DominikWawak/Project2/images/background.jpg

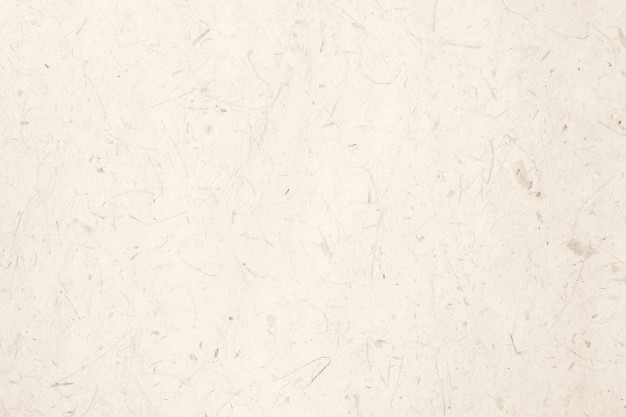
images/background.jpg
