DominikWawak/Project2/images/drawerbg.jpg

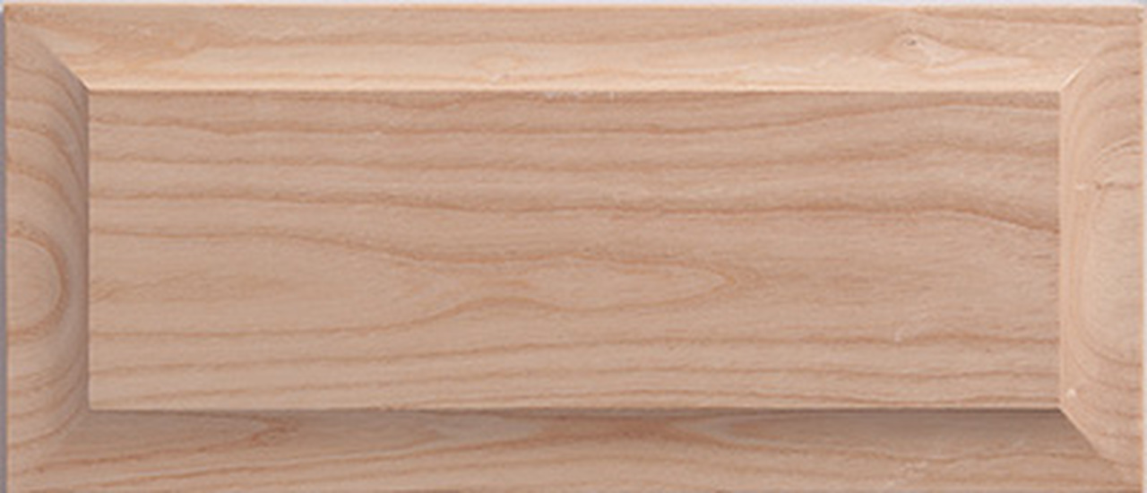
images/drawerbg.jpg
