DominikWawak/Project2/images/drawerfront.jpg

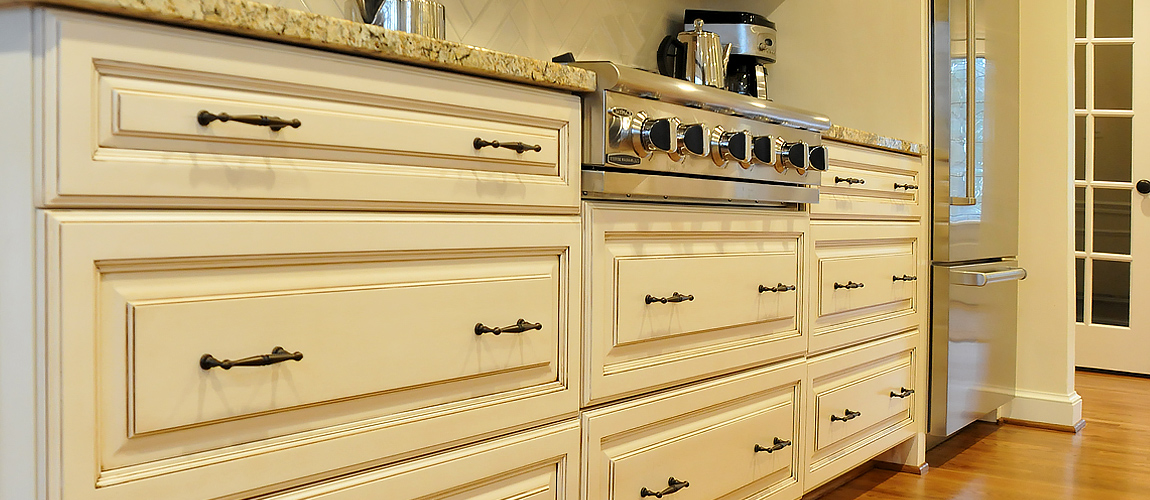
images/drawerfront.jpg
