DominikWawak/Project2/images/lost.png

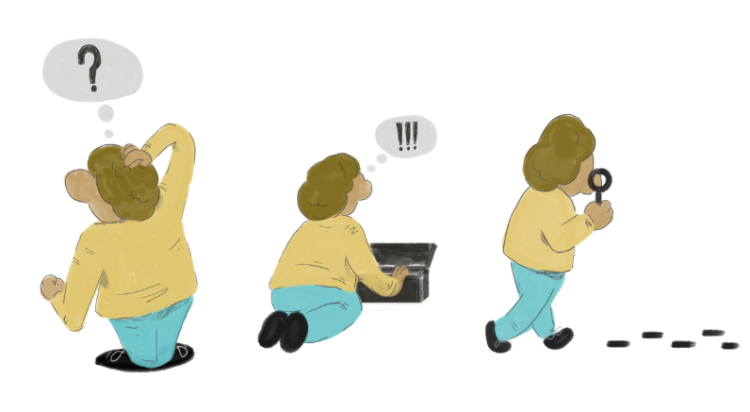
images/lost.png
