DominikWawak/Project2/Pictures/slidy1.jpg

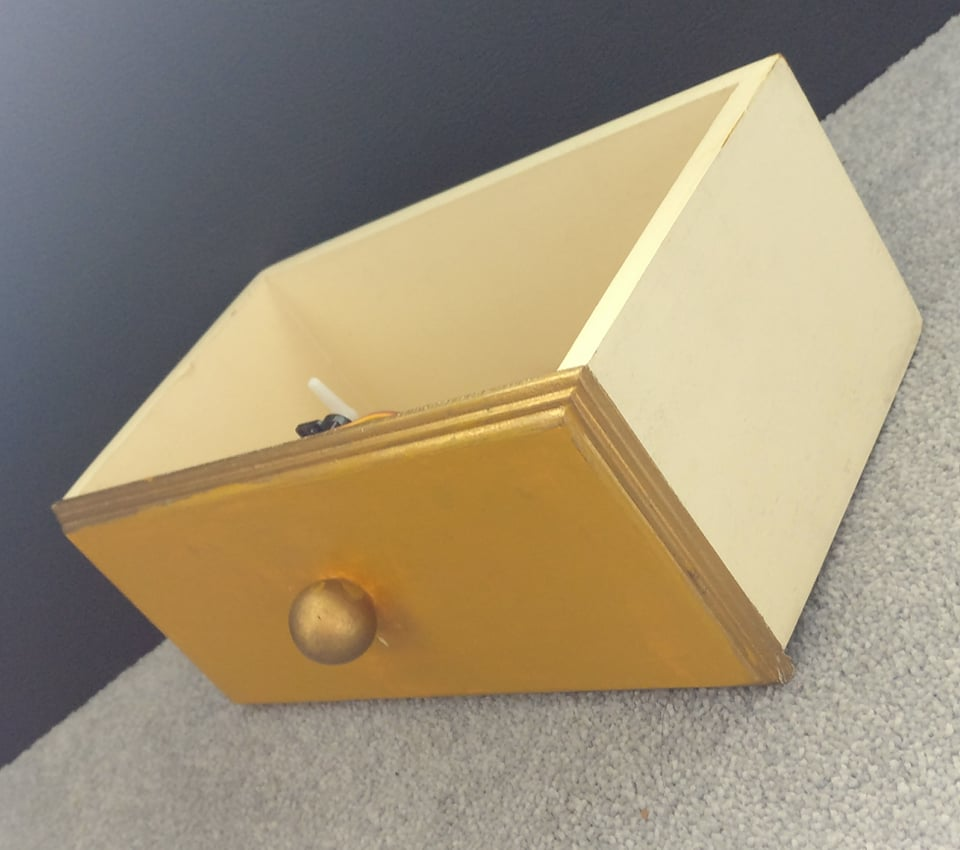
Pictures/slidy1.jpg
