DominikWawak/Project2/howtodo.html

# IoT Project

# How to Make Slidy

Slidy About How to make

## BUILD YOUR OWN SAFE SMART DRAWER

This project can be made by anyone. With just a bit of equipment, basic computer skills and innovation you can have your own personal Secure Smart Drawer controlled by your own telegram bot. In the end your drawer will be able to lock and unlock with a simple text! As well as notify you whenever an item has been added or removed with the items weight. Pretty Cool, huh?

What we need:

- Drawer, I used a small one you can use bigger.
- Firm plywood (non bendable)
- House hold tools eg: a hand saw, glue etc.
- Raspberry pi, can be found here (https://www.raspberrypi.org/products/) it will be usefull if you can ssh into your raspberry pi there are many tutorials online.
- Servo Motor, can be found here (https://uk.banggood.com/TowerPro-SG90-Mini-Gear-Micro-Servo-9g-For-RC-Airplane-Helicopter-p-1009914.html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¤cy=EUR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).
- Load Cell with Analog to Digital converter, can be found here (https://www.digikey.ie/product-detail/en/dfrobot/SEN0160/1738-1127-ND/6588549?productid=).
- Jumper Wires to connect the devices.
- A computer and mobile phone with internet connection
- A brain

### NOTE: This is the code source for this project and is reffered to throughout the tutorial. The link is: https://github.com/DominikWawak/Project2

#### Part 1: Setting up the bot

Dolwnoad Telegram on your phone. Next search "Bot Father" inside telegram. Follow his Instructions to create a /newbot ...

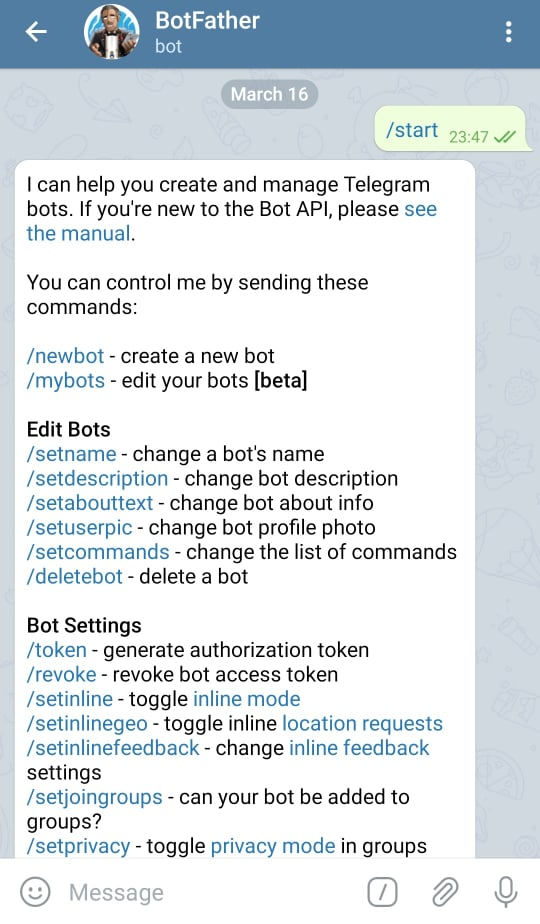
[picture p13: images/BFScreen.jpg]
botfather screenshot


After you have made your bot you will get a mesage with your access token, TAKE NOTE OF THE ACCESS TOKEN, we will need it later on. Now you can search telegrm for your bot with the name you have given him. He cant do much ... yet.

#### Part 2: OPEN - CLOSE

In this step have your raspberry pi ready (no need to turn it on). We will use a servo motor to open and close our drawer.

How servo motors work:

The servo motor has 3 wires, the red is the power which needs voltage, the brown is the ground wire and the most important is the yellow control wire. Through the yellow wire we can apply a pulse whose duration will turn the motor to a specific angle. This principle is called pulse width modulation The servo motor is made up of a DC motor controlled by a variable resistor and gears. Pulse width modulation has two main components: duty cylce and frequency. Duty cylcle tells the amount of time a signal is on (as a percentage)and the frequency tells how fast the pwm runs a cycle per second.

Servo motors come with various arm atachements I used one that came with the motor however if you want your lock to be more durable you can make your own lock arm and fit it securely on the servo motor (I would advise doing this last).
How to connect the servo motor:

- Yellow (controller) - GPIO pin 26
- Red - 5V pin
- Brown - GND pin

NOTE: Useful tip is to use command pinout on the raspberry pi to see the all the pins

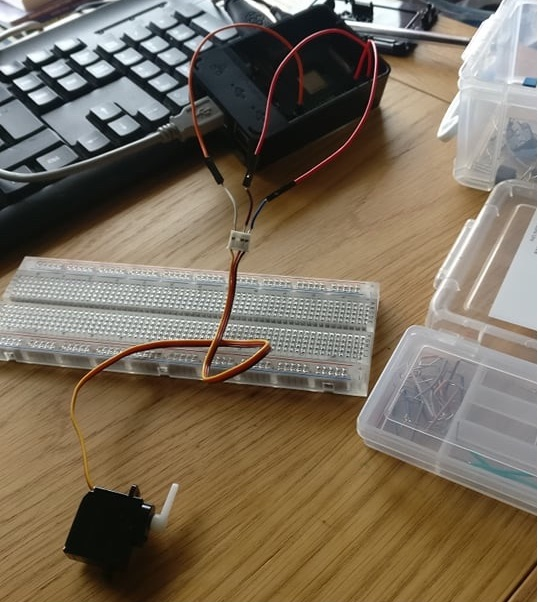
[picture p14: images/servoconnect.jpg]


##### Test

Now we can finally test if the project works so far! Here are the steps :

1. Turn on the raspberry pi and clone or download the github repo (mentioned at the start)
2. Installations: in your raspberry pi terminal run this command sudo pip install telepot
3. On the pi terminal use the cd command to navigate to /Project2/Test/BUTTONSERVOLOCK and use the command nano bottest.py to open the text editor look through the code until you can see where you need to enter your bots Access Token.

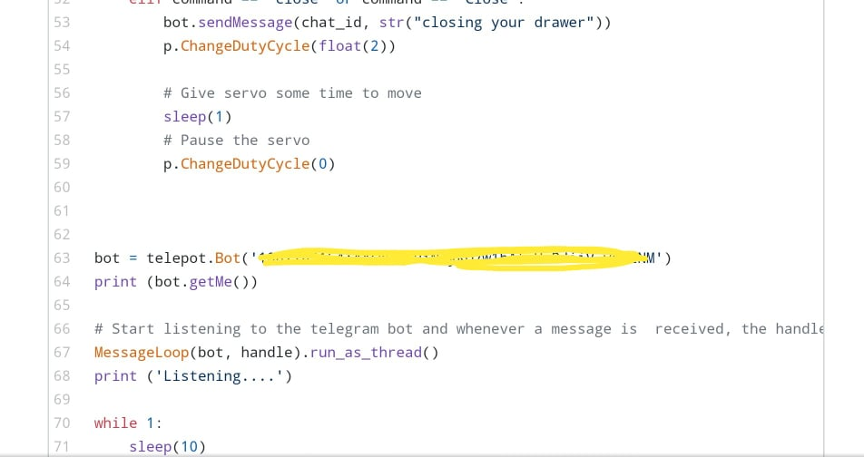
[picture p15: images/botaccess.jpg]


4. Finally we are ready! While being in the BOTTEST DIRECTORY type in sudo python bottest.py.
5. If you have done each step correctly your terminal should say "listening..." and if you send a massage saying "open" or "close" the servo motor will react.
6. The servo motor is made to rotate 180 degrees you can play around with that and your locking arm.

#### Step 3: Weight Sensor

This step involves some creativity as there are many ways to set up the load cell.

How load cells work:

The load cell used in this project is rectangular piece of aluminium with two machined holes in the middle. The holes make the load cell vunerable to being bent slightly. There are four resistors around the machined holes area and they compress or streach when a weight is placed on the cell. The working princepal of the load cell and the resistor is based of a wheatstone bridge which helps to read the tiny variations of resistace like potential divider. The tiny resistance is read and amplified by the analog to digital converter.

Ways to set up a load cell can be seen below in the test section. You can either use the holes in your load cell and attach your load cell with screws in your drawer or like me attach it to a block first and and then attach the block inside the drawer.

NOTE: most important thing is to keep the machined holes in the air unsupported, and then using screws make sure they are tight and prevent slip.

Connections: the load cell has four cables the letters correspond to the A to D converter:

- Red - E+
- Black - E-
- Green - A- (S-)
- White - A+ (S+)

Most popular converter used with these cells would be the HX711 how ever I use one that came with my load cell from DFROBOT

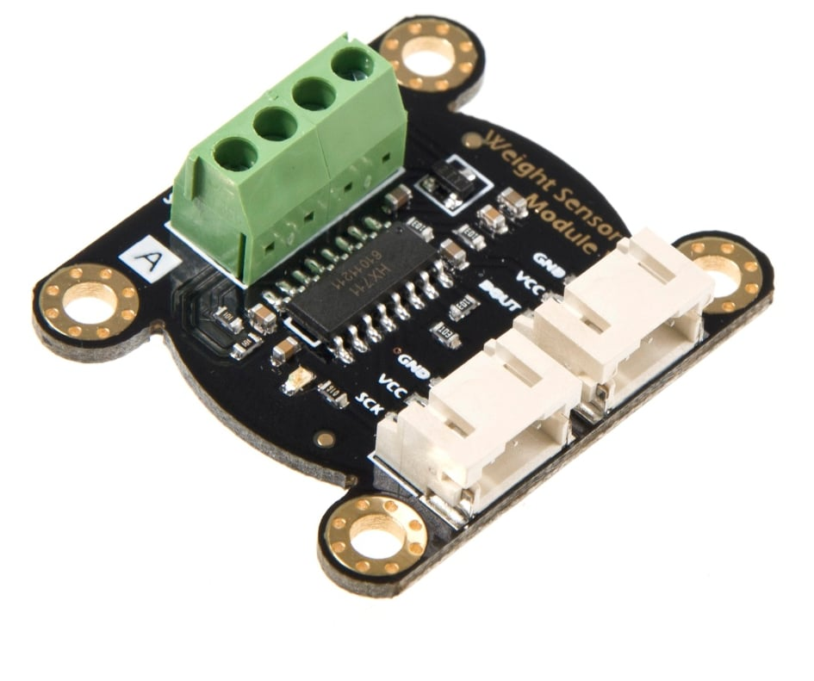
[picture p16: images/dfrobot.jpg]
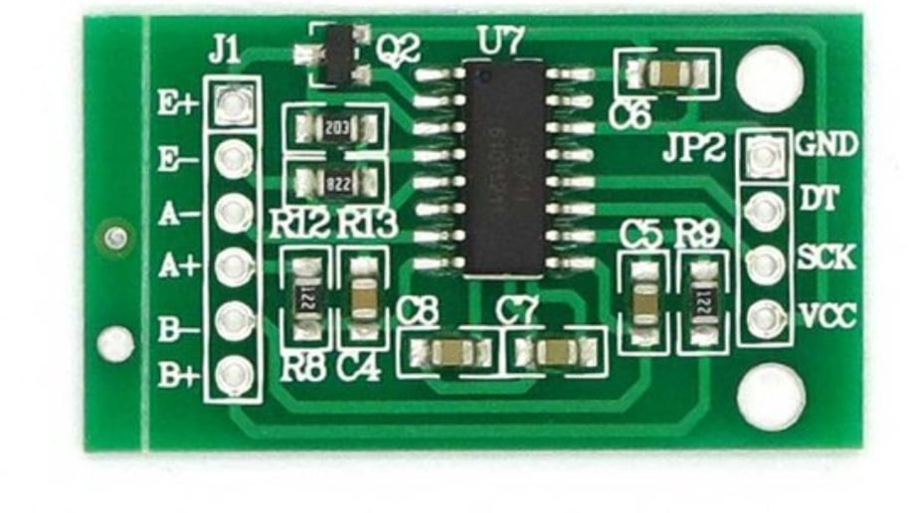
[picture p17: images/hx711.jpg]
 

Now connecting the converter to the raspberry pi :

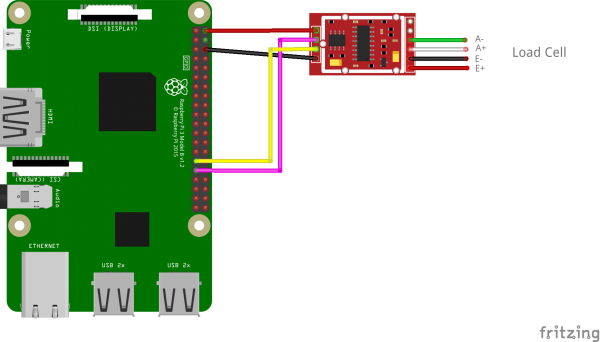
[picture p18: images/loadcellconnect.png]


When connecting to the converter some may have 2 VCC and GND connectors in that case you need to join both together like I did

- VCC - 5V pin (You can use a different 5V pin if you already have the servo morot in one)
- GND - GND pin
- DT - GPIO pin 27
- SCK - GPIO pin 17

##### Test

Now we can move on to the testing your load cell should be connected to the raspberry pi and the converter, and your load cell should be simply set up maybe like so:

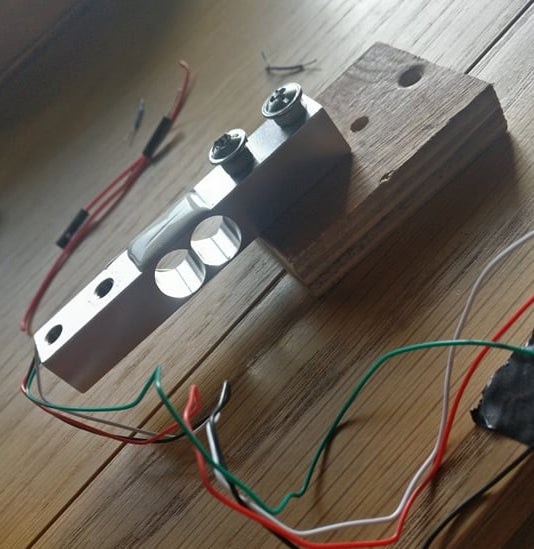
[picture p19: images/setupblock.jpg]
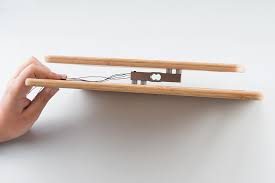
[picture p20: images/setupscrews.jpeg]
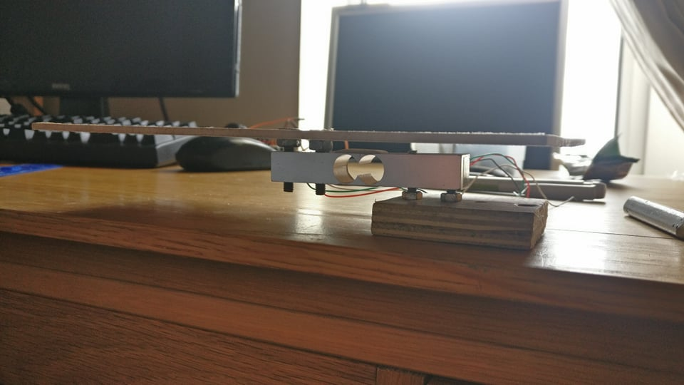
[picture p21: images/mysetup2.jpg]
  

On the raspberry pi navigate to the Project2/Tests/weightSensor with the cd command. We need to calibrate the weight sensor we can do this by :

- run the python script sudo python weight_test2.py
- You should get somewhat a constant value being outputted to the console like for me it was around 80590 (Note if your values are negative then maybe its your green and white wires from the a to d converter connected wrong try switching them.)
- Using nano or a different editor in the show_weight() function subtract your value from actualw
- If you run your programme now it should firstly read about zero however if you place a known weight like a kitchen ingridient on it, it will now show the actual weight.
- To get the actual weight place a known weight on the load cell with the programme running and record the value. Divide that value by your weight in grams. eg. if my output value is 1594 and my weight is 100g then my result is 15.9
- Now take your result and once again put it in the show_weight() function and divide your actual value by the result from previous part. eg. actualw = (w -80590)/16 (I rounded of my value)

#### Part 4: Putting it all together

So far we have two devices, you may be happy with them and maybe you just want to use them to make your own project thats perfect!

To make the drawer you will need to use some creativity it wont be the same as for me. The first thing is you need to cut the plywood to fit the inside of your drawer like so :

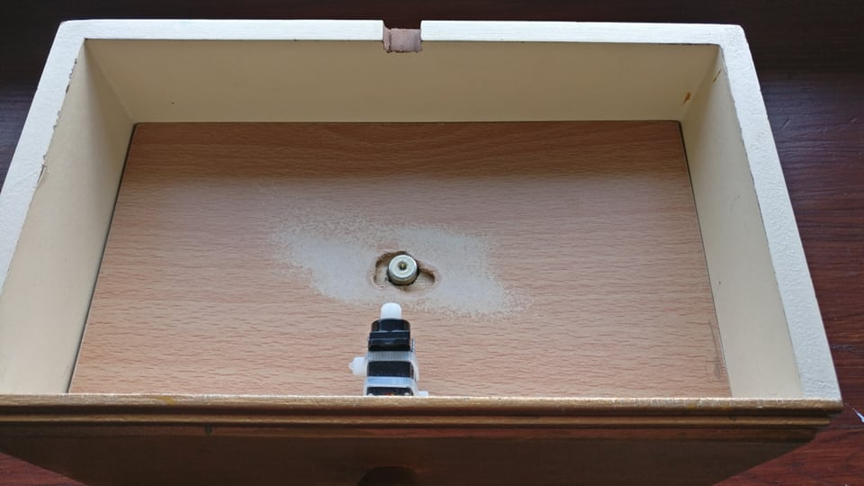
[picture p22: images/drawerfloor.jpg]


The fit of the plywood should be loose enough to move up and down without catching onto anything. Remember the plywood needs to be firm and the bigger your drawer the more non bendable it will have to be.

The second thing is to attach the load cell inside the drawer, you might have used just screws to attach it thats okay, if you did it like me and attached it to a block with screws first you will have to glue or screw the block to the drawer (I did both). The position of the load cell isnt really important if you have it secured in place, I placed mine in the middle.
The second important attachement is fixing the plywood bed/plank to the load cell, I tried screws and it works however for the purpose of presenting the project I didnt want to fix the bed in place forever therefore I was lucky to find a random metal piece with a cylinder sticking out I was able to drill a whole in my plywood and support it , THIS WILL NOT BE THE MOST ACCURATE . If you plan to use this daily I would reccomend the screws or maybe you have a better idea?
NOTE: Dont use magnets to attach the plwood, I have tried with a magnet and it was throwing my values off (fluctuating).

Now drill or make a small hole in your drawer for the power cable for the raspberry pi and fit all of your devices inside like so:

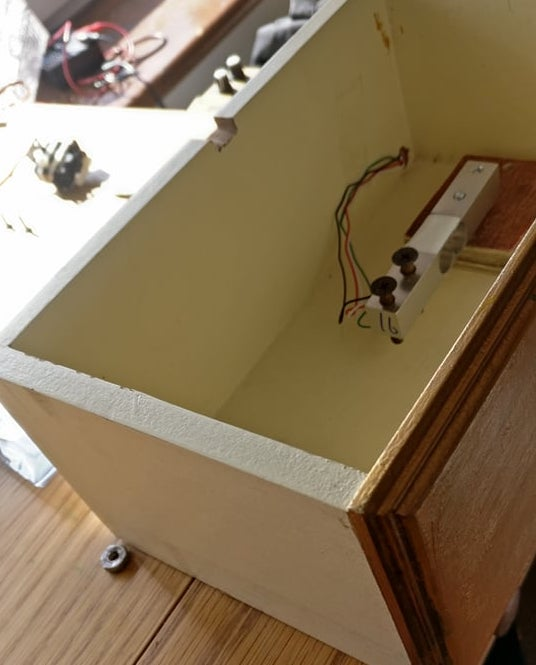
[picture p23: images/insidedrawer1.jpg]


Now drill or make a small hole in your drawer and the the "shelf" of your drawer, for the power cable for the raspberry pi and fit all of your devices inside like so:

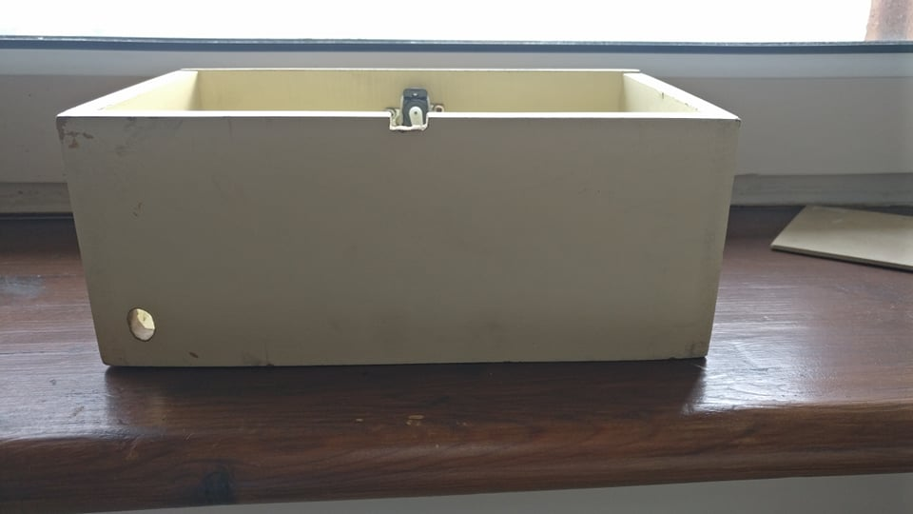
[picture p24: images/drawerback.jpg]
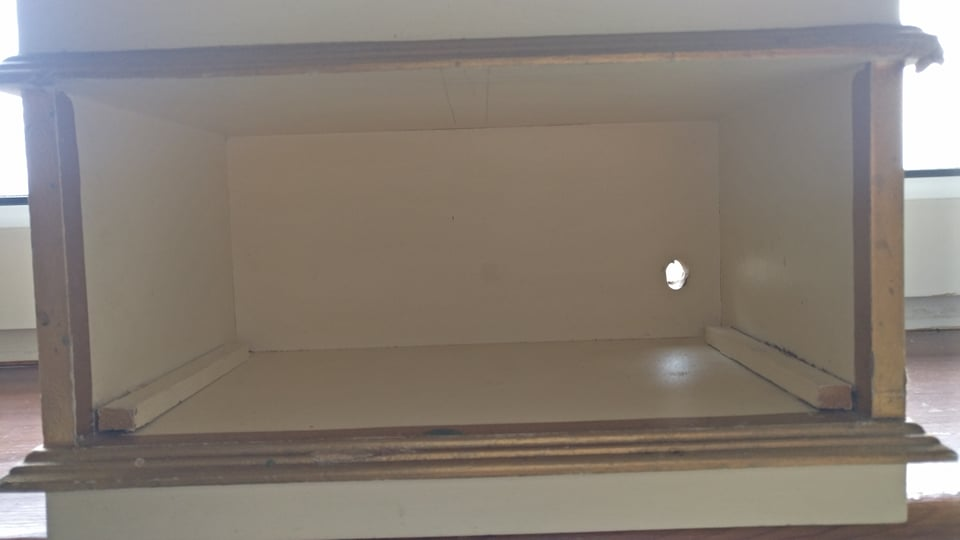
[picture p25: images/shelfback.jpg]
 

The last step is positioning the lock and attacking the servo motor I have bended two pieces of aluminium I found around the house you can also get L shaped backets, I have zip tied them to the motor. You will need to see how this will fit in your drawer (based on your closing arm), My solution was to glue a small piece of wood or anything strong inside my drawer so when the arm of the servo motor rises it will block itself. (as you can see the notch on the picture above is for the small block inside where the drawer sits in.)
Also you may use the holes on the servo motor to attach it. The arm of the servo motor may fall off easily so maybe if you plan to use it often glue it in place with care for the motor shaft.

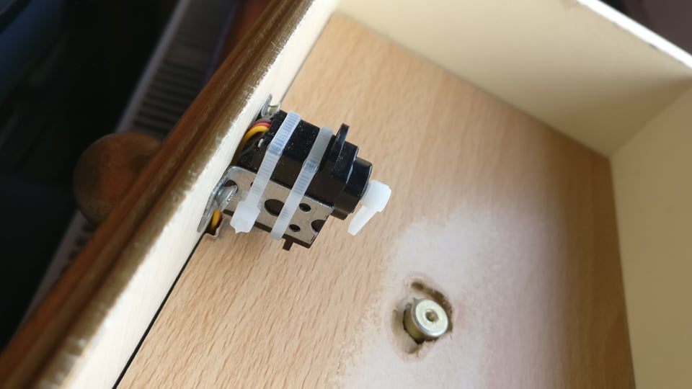
[picture p26: images/servoattach.jpg]


Now to test the whole application need your chat id in order to send messages from the bot to you this can be obtained by navigating to https://api.telegram.org/bot ENTER ACCESS TOKEN HERE /getUpdates and now send a random message to your bot and refresh the page you will see a lot of details including the chat id, enter the chat id to the code where required.

Fitting all the devices inside the drawer and connecting them:

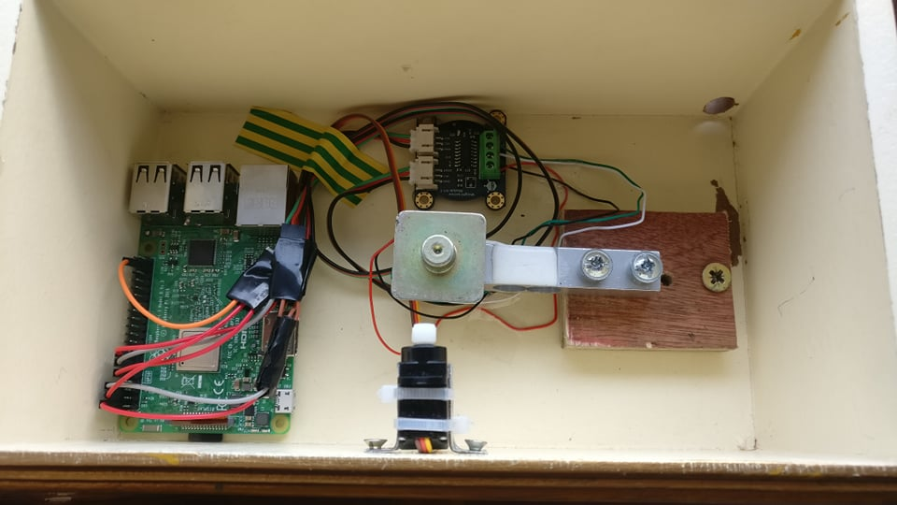
[picture p27: images/alldevices.jpg]


Now you can run your drawer by running the apptest.py just like the other tests were ran, remember to enter your tokens and chat id's there where required. Run the app and if all is good you should be notified then theres any interaction with the floor of your drawer, also your open and close commands should work.

##### Additional:

How to make your programme run whenever you plug in your raspberry pi:

- Firstly run this comand sudo nano /home/pi/.bashrc
- Now scroll down to the end of the file and at the very end type this in sudo python /home/pi/YOUR PATH TO THE PROGRAMME.
- now reboot your pi and your programme will run on boot, also it will run when you ssh or open a new terminal window.
- to exit you need to ssh to your raspbery pi and ctrl c or connect your raspberry pi normally and ctrl c there.

### AND WE ARE DONE!



##### Written by Dominik Wawak - 13/4/2020 This was a student project
