DominikWawak/Project2/(commit log)

2020-03-13 controlling a servo from the web
2020-03-30 weight sensor added
